shrimp19789/Chariot_strom_of_gear/firmware/chassis/TB6612LogicCheck/README.md

# TB6612LogicCheck：第2步逻辑验收

适用经典 ESP32，按 `docs/麦轮TB6612接线与面包板排线.md` 接线。编译目标 `esp32:esp32:esp32`，已在 Arduino ESP32 3.3.12 编译。本固件替换板上程序，原 PS2Catapult 源码不变。

只用于 VM 和投掷动力断开的逻辑检查。启动首先拉低 GPIO33，再拉低投掷 EN14、四轮八个 IN 和投掷相控制25/26/27；运行中持续保持低。未使用 PWM/SimpleFOC，不测试 PS2 或 AS5600，不支持任何使能、点动、制动命令。

串口115200，以换行结束：`STATUS` 输出主控引脚数字回读；`STOP` 再次拉低所有上述输出并回复。其他命令和超长行报错且保持禁用。每秒自动输出一次状态。`pads_low=1` 只表示这些主控引脚当前数字采样为低，不能证明远端接线、模拟电压或复位期间无短暂脉冲。

保持动力断开，在两块驱动板各自端子测 VCC、PWMA、PWMB 应约3.3V，STBY应约0V。冷启动/下载/复位阶段需要外部10kΩ下拉，瞬态需示波器或逻辑分析仪验证。该固件不能替代这些测量，不能作为第3–5步动力验收固件。
