shrimp19789/Chariot_strom_of_gear/docs/排错对话log.md

工具可用：6 秒内发了 7 次，板上 `duty=0,128,0,0` 反复到满、`STBY=1`，退出时自动发了 `STOP` 回到 `LOCKED`。

---

# 第 1 步结论：共因故障

| 已验证 | 结论 |
|---|---|
| 电机直连电源 → 转 | 电机、齿轮箱、轮子、电源本身 **全部正常** |
| FL（GPIO16/17）不转 | — |
| **RL（GPIO18/19）6V/50% 不转** | GPIO18/19 在任何 ESP32 模块上都安全，**排除 PSRAM 占用** |
| **两个轮子都不转** | **排除 FL 接线错位、排除单个 GPIO 问题** |

**所以故障在两者共有的环节。** 我之前列的三条 FL 特有嫌疑（PSRAM、FL 排线、FL 电机）**全部排除**。

---

# 剩下的嫌疑人（都是共有的）

按我的怀疑程度排序：

### 🔴 1. STBY 那条线实际没通到板上（最大嫌疑）

理由很硬：

- **STBY 是唯一的共用使能** —— 它一低，两块板一起待机，**四个轮子在任何 VM 下都不会动**
- 你实测 **STBY = 0.4V**，而固件同时报 `STBY=1`。**GPIO33 读回是高电平，板端子却是 0.4V —— 中间差 2.9V，这根线有问题**
- 0.4V 既不是干净的 0V、也不是 3.2V。**这是整份数据里最反常的一个数字**，验收记录自己也标注了"不能写成0V"，但从没解释过它
- 它**完美解释"6V 也不转"** —— VM 再高，芯片在待机就是不输出

**注意**：第 7 排是全表最复杂的一排 —— GPIO33、D1 STBY、10kΩ 下拉三个东西在同一个网络上，再加一条跨槽桥。**放错一位的代价恰好就是"STBY 被 10kΩ 拉死"。**

### 🔴 2. 功率地缺失

电机电流要有回路：`VM → 芯片 → BO1 → 电机 → BO2 → 芯片 → 功率GND → 电源负极`。
**如果 D1 的功率 GND 没接到公共地端子，逻辑电压全正常、电机却一点不转。** 验收单里 `G-01`/`G-02` 那两行还是空的。

### 🔴 3. VM 从未在板端子上量过

你说"现在就是6V"，但那大概是**电源显示的读数**。验收单 `M-01`/`M-02` 至今空着 —— 电源显示 6V、板端子 0V，是可能的。

### 4. IN 引脚没真带着 PWM（第 3–6 排排错）
### 5. 电源限流太小，一启动就进恒流、VM 塌陷

---

# 现在做第 2 步：边持续点动边测

工具已经就绪。**跑这条命令（30 秒），然后在这 30 秒里量 D1 的四个点：**

```powershell
python host\jog_loop.py --wheel RL --duty 128 --seconds 30
```

**万用表直流档，黑笔接已确认的公共地，红笔点器件端的针。** 直流档读的是**平均值**，所以 50% 占空比会显示约一半的值 —— 这正是判断依据。

RL 走的是 D1 的 **B 通道**，所以测这四个：

| 测点 | 在 D1 的哪根针 | 应该读到 | 读到别的说明什么 |
|---|---|---|---|
| **VM–GND** | `VM` | **≈6V 稳定** | 0V 或来回跳 → 供电/限流/**功率地没通**（嫌疑 2、3、5） |
| **STBY–GND** | `STBY` | **≈3.2V** | 仍是 **0V 或 0.4V → STBY 线没通，芯片一直待机**（嫌疑 1） |
| **BIN1–GND** | `BIN1` | **≈1.6V**（50%×3.3V） | ≈0V → IN 线或面包板第 5 排排错（嫌疑 4） |
| **BO1–BO2** | `BO1` 与 `BO2` 两针之间 | **≈3V**（50%×6V） | 前三个都对、这个为 0 → 驱动板本身坏 |

**判定逻辑是一条链，测到哪一步断掉，答案就在那里：**

```
VM 有 6V？
 ├ 没有 → 供电/地的问题，与固件无关
 └ 有 → STBY 有 3.2V？
         ├ 没有 → 【就是它】STBY 那条线 / 10kΩ 位置
         └ 有 → BIN1 有 1.6V？
                 ├ 没有 → IN 排线错（第 5 排）
                 └ 有 → BO1-BO2 有 3V？
                         ├ 没有 → 驱动板坏
                         └ 有 → 电机侧（但第 0 步已证明电机好）
```

**这四个数一出来，基本就定案了。** 其中 **STBY 那格最关键** —— 我赌它读不到 3.2V。

---

## 两个补充

**① 别只测 D1。** 顺手在 D2 的 `STBY` 上也量一下：如果 D2 也读不到 3.2V，那就确认是**共用的 STBY 链路**（第 7 排 + 跨槽桥）的问题，一处修好四个轮子都活。

**② 那个 94% 的循环对"看轮子"够用，对"测电压"略勉强。** 如果你想要一个**完全不间断**的稳态输出（点一下就一直转，靠 `STOP` 或按任意键停），我可以给固件加一条 `HOLD <轮> <占空比>` 命令并重新烧录 —— 那样测量会舒服得多，也不用和 800ms 赛跑。要的话我直接做。

---

`host/jog_loop.py` 是新加的文件，现在还没提交。要我把它一起提交吗？（它会进 `host/`，和 `serial_watch.py` 那几个诊断脚本放一起。）
---

用户：
发现问题：VM–GND是6V稳定 STBY-GND是3.3V BIN1-GND在1.6V和0V之前反复跳动 BO1-BO2显示0V

---
这组数据很干净，**而且推翻了我的首要嫌疑** —— STBY 是好的。

## 先说排除掉的

| 读数 | 结论 |
|---|---|
| **VM–GND = 6V 稳定** | ✅ 供电正常、**功率地正常**（能对公共地测出 6V 就说明地通了）、没进恒流 |
| **STBY–GND = 3.3V** | ✅ **我赌错了** —— STBY 链路是通的，芯片不在待机 |
| **BIN1 在 1.6V/0V 间跳** | ✅ **这是正常的**，见下 |

**BIN1 那个"跳动"要解释一下**：我用 `jog_loop` 是每 800ms 发一次点动、间隔约 60ms。所以占空比 50% 时 BIN1 平均是 1.6V，而那 60ms 间隙里固件归零 → 0V。**万用表跟着在 1.6V 和 0V 之间摆，恰好证明 BIN1 上有真实的 50% PWM。这不是故障，是测法造成的。**

所以输入侧全部正常：**VM 有、STBY 高、BIN1 有 PWM。**

---

## 关键矛盾：输入全对，输出为 0

**`BO1–BO2 = 0V` 是整份数据里唯一的异常，而且是决定性的。**

按真值表，把 PWM 脚视为总闸：

| PWMB | BIN1 | BIN2 | 输出 |
|---|---|---|---|
| **H** | PWM | L | **交替：驱动 6V ↔ 高阻滑行** → 万用表应读 **≈3V** |
| **L** | 任意 | 任意 | **一直短路制动，两输出都拉低** → **读 0V** ✅ 完全吻合 |
| H | L | L | 高阻 Stop → 读 0V ✅ 也吻合 |

**能产生 `BO1-BO2 = 0V` 的只有两种情形，都指向具体位置：**

### 🔴 嫌疑 A：PWMB 没真的在 3.3V（最可能）

**关键点：`PWMA`/`PWMB` 是纯硬件接死的，固件根本不碰这两个脚** —— 所以它们不是 3.3V 就只能是接线问题，而且**一错就让整条 B 通道全灭**。

你的 PWMA/PWMB=3.2V 是**很早测的**（当时 STBY 还是 0.4V，即锁定态）。之后排线动过好几轮。第 9 排的 3.3V 是从**左电源轨另取一孔**引到 a9 的 —— 那根跳线若掉了或插错到 GND 轨，现象就正好是现在这样。

### 🔴 嫌疑 B：BIN1 的跳线没通到芯片

如果 `e5 → D1 BIN1` 那根没通，芯片看到的 BIN1 就是低 → `IN1=IN2=L` + `PWM=H` → **高阻 Stop → 0V**。你在面包板侧量到 1.6V，但芯片没收到。
（这也是为什么下一步要**贴着板子针脚量**。）

### 🟠 嫌疑 C：D1 这块板已经坏了

必须提这一点：**最早几次测试是在 VM=12V 上跑一颗额定 3–6V 的电机。** 那是过压 2–4 倍，堵转电流可能远超单路 1.2A 的额定。TB6612 有过流/过温保护，触发后可能锁存。**而且从记录看，这颗板从来没成功驱动过任何电机。**

---

## 下一步：三条测量，一次定案

### 第 1 优先：量 PWMB（顺便 PWMA）

```powershell
python host\jog_loop.py --wheel RL --duty 128 --seconds 40
```

RL 跑起来后，**贴着 D1 的针脚**量：

| 测点 | 应读 | 读到别的 → 结论 |
|---|---|---|
| **D1 `PWMB`–GND** | **3.2~3.3V** | **0V 或悬空 → 嫌疑 A，就是它** |
| **D1 `BIN2`–GND** | **0V 恒定** | 也在跳 → BIN1/BIN2 短路或错位 |

### 第 2：让 FL 也跑一次（它从没被公平测过）

```powershell
python host\jog_loop.py --wheel FL --duty 128 --seconds 40
```

**这一点很重要**：FL 之前三次测试都是 **3V + 弱参数**（duty 9/12/96、400ms），从来没在 6V/128/800 下测过。所以 **FL 的"不转"可能纯粹是推力不够，而不是故障。**

量 D1 的 **`PWMA`** 和 **`AIN2`**（AIN2 应恒 0V）。如果 PWMA 正常、FL 也转了 → **说明只有 B 通道有问题，A 通道是好的。**

### 第 3：拿 D2 做对照 —— 这能一刀切开"坏板"和"接线"

```powershell
python host\jog_loop.py --wheel FR --duty 128 --seconds 40
```

FR 在 **D2 的 A 通道**（GPIO23/32），量 **D2 的 `PWMA` 和 `AO1–AO2`**：

| D2 结果 | 结论 |
|---|---|
| D2 的 AO1–AO2 有 ≈3V、轮子转 | **D1 这块板有问题**（嫌疑 C），D2 好 |
| D2 也 0V | **共因**，回到"PWMA/PWMB 的 3.3V 供法"上（第 8、9 排 + 左右轨取电） |

---

## 判定速查

```
D1 PWMB 是 3.3V 吗？
├ 不是 ────────────────► 嫌疑 A：补/换第 9 排那根 3.3V 跳线，收工
└ 是 → BIN1 贴着针脚还有 1.6V 吗？
        ├ 没有 ─────────► 嫌疑 B：e5→BIN1 跳线断了
        └ 有 → D2 的 AO1-AO2 有 3V 吗？
                ├ 有 ────► 嫌疑 C：D1 坏板，换板
                └ 没有 ──► 两块板都 0V，查 PWMA/PWMB 的 3.3V 分配（第 8/9 排 + 轨）
```

---

## 顺带两件事

1. **`host/jog_loop.py` 还没提交**，要我提吗？（它已经在排查里起了关键作用，值得留在 `host/` 里）
2. **测量时黑笔一定接已确认的公共地**，而且要**贴着模块针脚量** —— 量面包板那一侧会掩盖"跳线到模块之间断掉"这类故障，这正是嫌疑 B 的形态。

我赌 **PWMB**。把那两个数报我。
