shrimp19789/Chariot_strom_of_gear/docs/烧录测试记录.md

# Arduino 烧录测试记录

> 本记录写于仓库重组前；当时路径 `D:\dsh\1001\ESP小车项目\` 即现在的仓库根。固件在 `firmware/`、脚本在 `host/` 与 `tools/`、日志在 `docs/logs/`。

日期：2026-10-05（北京时间）

已阅读项目 `README.md`、`docs/ESP32-2804-FOC-guide.md`、`docs/诊断记录-第一阶段.md`，并检查现有固件与烧录脚本。

## 已完成

- 实测串口：COM9，USB-SERIAL CH340，VID:PID=1A86:7523。COM7/COM8 是蓝牙串口。
- 实测芯片：ESP32-D0WD-V3，revision v3.1；Flash 4 MB；MAC 08:a6:f7:a8:95:94。
- 编译目标：esp32:esp32:esp32；ESP32 core 3.3.12；Simple FOC 2.4.0。
- Stage1_AS5600Test 编译通过：程序 320316 字节（24%）；全局变量 23564 字节（7%）。
- 以 115200 上传成功，bootloader、分区表、boot_app0、应用均通过写入哈希校验，退出码 0。
- 上传后复位并读取串口 10 秒，新固件正常启动；GPIO14 EN 拉低。
- AS5600 在 GPIO21 SDA / GPIO22 SCL 的 I2C 地址 0x36 应答。
- 采样读数稳定：raw=598，deg=52.56，MD=1，ML=1，MH=0，changes=1。
- Stage2_FOCClosedLoop 编译通过：程序 328852 字节（25%）；全局变量 24500 字节（7%）。仅编译，未上传，未解除配置锁。
- 用户回复“开始”后采集 30 秒动态测试数据：60 条 I2C ERROR，0 条有效角度样本；无法验证角度范围与回绕。
- 动态测试后复位并发送 S 重扫：GPIO21 空闲=0，GPIO22 空闲=1；0x36 无应答；总线扫描发现 0 个器件，NACK=112，超时=0。

## 结论与限制

串口、两个阶段的编译、第一阶段上传和启动均通过。编码器初次读取正常，但动态采集时通信失败，复位后依旧无应答；编码器测试未通过。

初次 ML=1 表示传感器报告磁场偏弱。动态采集没有有效角度，无法判断整圈范围、回绕或运动时磁场状态。现象提示接线或供电不稳定，但不能仅凭这些读数证明线断或芯片损坏。优先断电检查 GPIO21 到编码器 SDA 的通断及接触，再检查 VCC 和 GND；通信恢复后核对磁铁距离与对中。

尚未执行电机校准或带电试转，第二阶段配置保持 CONFIG_CONFIRMED=false。板上保留第一阶段诊断固件，串口读取结束后已关闭。

## 工具问题

原 MCP 串口读取函数收到数据后会把截止时间延长 0.4 秒，持续输出会导致读取不返回并占用串口。USB 重插后占用释放，本次后续验证使用固定截止时间的独立脚本，读取结束后关闭串口。未修改原项目和 MCP 服务源码。

原始日志（均在 `docs/logs/` 下）：stage1-startup.txt、stage1-rotation.txt、stage1-recheck.txt。
