shrimp19789/Chariot_strom_of_gear/docs/环境检查报告.md

# 本机环境检查报告

> 本记录写于仓库重组前；当时路径 `仓库根` 是行驶底盘子项目，现已并入本仓库：固件在 `firmware/chassis/`、脚本在 `host/` 与 `tools/`。下文旧路径已更新。

检查时间：本次会话
检查目标：Arduino / Codex 能否调用，串口与 ESP32 板子现状，以及为完成「链路检测 + 电机驱动」
还缺什么。

---

## 一、总体结论

| 检查项 | 结论 | 证据 |
|---|---|---|
| Arduino IDE | ✅ 有（**便携版**，不在 PATH） | `D:\Download\arduino\Arduino IDE.exe`，版本 2.3.10 |
| arduino-cli | ✅ 有且可调用 | 1.5.1，藏于 IDE 内部 |
| ESP32 核心 | ✅ 已装齐 | `esp32:esp32 3.3.12` |
| AVR 核心 | ✅ 已装 | `arduino:avr 1.8.8` |
| ESP8266 核心 | ✅ 已装 | `esp8266:esp8266 3.1.2` |
| Codex | ✅ 有且可调用 | `codex-cli 0.160.0` |
| 电机驱动板 | ✅ 型号已确认 | 奇果派 QGPMaker（PCA9685） |
| 串口板子 | ⚠️ **未插入** | COM9 = CH340，状态 `Unknown` |
| 网络 | ✅ 可用 | 7gp.cn 返回 200；pip 可下载 |

**两个工具都能调用，板子确实还没插上——与你的说明一致。**

---

## 二、Arduino 工具链

### 2.1 关键路径

| 用途 | 路径 |
|---|---|
| IDE 启动器 | `D:\Download\arduino\Start Arduino IDE.cmd` |
| arduino-cli | `D:\Download\arduino\resources\app\lib\backend\resources\arduino-cli.exe` |
| arduino-cli 配置 | `D:\Download\arduino\data\arduino-cli.yaml` |
| 数据目录（核心/工具链） | `D:\Download\arduino\data` |
| 项目目录（sketchbook） | `D:\Download\arduino\sketchbook` |

**为什么 `arduino-cli` 不在 PATH**：这套 Arduino 是**便携（portable）安装**——
数据目录被搬到了 D 盘（`Start Arduino IDE.cmd` 里写明原因是 C 盘只剩约 9GB）。
因此必须显式指定 `--config-file`，否则 arduino-cli 会去默认位置找核心、然后找不到 ESP32。

### 2.2 已安装核心与工具链

```
arduino:avr      1.8.8
esp32:esp32      3.3.12     ← 完整
esp8266:esp8266  3.1.2
```

ESP32 工具链齐全：

```
esp-x32 / esp-rv32              (编译器)
esptool_py 5.3.1                (烧录)
openocd-esp32 v0.12.0-esp32-20260424
esp32-libs / esp32c3/…/esp32s3-libs  3.3.12
xtensa-esp-elf-gdb / riscv32-esp-elf-gdb  17.1_20260402
mklittlefs 4.0.2
```

### 2.3 一个必须记住的坑

`Start Arduino IDE.cmd` 里有一条注释值得抄下来：

> `--disable-gpu-sandbox` 在本机是**必需**的。没有它，Electron 的 GPU 进程会以
> `0xC0000135`(STATUS_DLL_NOT_FOUND) 崩溃，IDE 会立刻退出。

**所以请始终用 `Start Arduino IDE.cmd` 启动 IDE，不要直接双击 `Arduino IDE.exe`。**

### 2.4 已安装的驱动库

| 库 | 状态 |
|---|---|
| `QGPMakerMotorShield_Lib_V5.2` | 原有（厂家库，AVR 版） |
| `QGPMakerMotorShield_ESP32` | **本次新增**，见第五节 |

---

## 三、Codex

### 3.1 结论

| 项目 | 值 |
|---|---|
| 版本 | `codex-cli 0.160.0` |
| 主程序 | `C:\Users\jiahe\AppData\Local\OpenAI\Codex\bin\f544b3844e0f14e9\codex.exe` |
| 是否在 PATH | ❌ 不在（需用全路径调用） |
| 配置 | `C:\Users\jiahe\.codex\config.toml` |
| 日志库 | `C:\Users\jiahe\.codex\logs_2.sqlite`（1859 条） |
| 状态库 | `C:\Users\jiahe\.codex\state_5.sqlite` |

同目录还有 `codex-code-mode-host.exe`、`codex-command-runner.exe`、
`codex-windows-sandbox-setup.exe`。

### 3.2 挖日志的结果：**Codex 日志里没有 ESP32 相关内容**

在 `logs_2.sqlite` 里逐关键字 LIKE 查询，**全部 0 命中**：

```
esp32 / arduino / motor / COM9 / CH340 / CP210 / serial /
pyserial / platformio / 电机 / 串口 / 驱动 / 舵机 / servo / stepper / L298 / TB6612 / pwm
```

原因也很清楚：

- 日志时间窗只有 **2026-10-05 17:09:09 → 18:23:04**（约 74 分钟）
- `state_5.sqlite` 的 `threads` 表**为空**（0 行）
- 磁盘上**没有** rollout `/ sessions/` 会话文件

也就是说这台 Codex 是**刚装不久、还没积累对话**，所以没有 ESP32 上下文可挖。
（`logs_2.sqlite` 里绝大部分是登录 `codex_login::auth::manager`、
WebSocket 传输和模型缓存类的记录。）

### 3.3 但挖到了关键线索：ChatGPT 项目镜像

真正有用的是这个文件：

```
C:\Users\jiahe\.codex\.chatgpt-projects\g-p-6ac37786ec188191b2b79cf5d7cf8330\AGENTS.md
```

内容：

```markdown
# ChatGPT project context
This directory is a local mirror of the ChatGPT project "ESP32".
- Treat every file under `sources/` as read-only reference material.
- ...
```

→ **存在一个名为 “ESP32” 的 ChatGPT 项目**，这印证了你的目标平台就是 ESP32。
（注意：该镜像的 `sources/` 目录目前是**空的**，项目文件还没同步下来。）

---

## 四、串口与板子现状

### 4.1 端口枚举

| 端口 | 设备 | 状态 | 判断 |
|---|---|---|---|
| COM7 | 蓝牙链接上的标准串行 | OK | 蓝牙虚拟串口，**忽略** |
| COM8 | 蓝牙链接上的标准串行 | OK | 蓝牙虚拟串口，**忽略** |
| **COM9** | **USB-SERIAL CH340** | **Unknown** | **就是你的板子，当前未插入** |

### 4.2 COM9 的进一步证据

- 注册表仍保留设备记录：
  `HKLM\SYSTEM\CurrentControlSet\Enum\USB\VID_1A86&PID_7523\5&347eed33&0&5`
- `VID_1A86 : PID_7523` = **CH340** USB 转串口芯片，
  ESP32 开发板（以及 UNO 兼容板）上最常见的那颗。
- 状态 `Unknown` = **设备当前不在场**（之前插过、驱动装过、现在拔了）。

**结论：CH340 驱动已经装好了**（`D:\Download\arduino\drivers\CH341SER.EXE` 也备着，
备用 CP210x 驱动在 `drivers\CP210x\`）。插上板子后应当能直接识别，
若真的没驱动再运行 `drivers\latest\Install-Latest-Drivers.cmd`。

### 4.3 怎么确认板子插上了

```powershell
tools\build-chassis.ps1 -ListBoards
# 或者
python host\motor_link_check.py --list
```

---

## 五、本次对本机做的改动（透明清单）

只做了**新增**，没有修改或删除任何原有文件。

### 5.1 安装了 Python 库

```
python -m pip install pyserial        →  pyserial 3.5
```
（上位机检测脚本需要它读串口。）

### 5.2 新增了一个 ESP32 版的驱动库

**问题**：厂家那份 `QGPMakerMotorShield_Lib_V5.2` **无法在 ESP32 上编译**：

```
PinChangeInterrupt.h:30:10: fatal error: avr/io.h: No such file or directory
```

因为该库目录里捆了 AVR 专用的 `PinChangeInterrupt*.cpp`（编码器功能用），
而 arduino-cli 会把库目录下所有 `.cpp` 都拿去编译 → ESP32 必然失败。

**这也是为什么厂家在资料包里**（`_net_test\7gp\v56\`）**单独放了一个 `esp32` 目录**。
对比后确认：

| 文件 | V5.2 版 vs 厂商 ESP32 版 |
|---|---|
| `QGPMaker_MotorShield.cpp` / `.h` | **完全相同**（SHA-256 一致） |
| `Adafruit_MS_PWMServoDriver.h` | **完全相同** |
| `Adafruit_MS_PWMServoDriver.cpp` | 内容相同，**仅换行符不同**（CRLF vs LF） |
| `PinChangeInterrupt*.cpp/.h` | 厂商 ESP32 版**故意不提供** |

**解决办法**：新增一个带 `library.properties`、且 `architectures=esp32` 的库：

```
D:\Download\arduino\sketchbook\libraries\QGPMakerMotorShield_ESP32\
├── library.properties          (architectures=esp32)
└── src\
    ├── QGPMaker_MotorShield.h        ← 取自厂商 ESP32 版
    ├── QGPMaker_MotorShield.cpp
    ├── Adafruit_MS_PWMServoDriver.h
    └── Adafruit_MS_PWMServoDriver.cpp
```

**为什么这样最干净**：arduino-cli 会按目标架构选库。
实测已验证两条路都正常：

```
Alternatives for QGPMaker_MotorShield.h:
  [QGPMakerMotorShield_Lib_V5.2  QGPMakerMotorShield ESP32@5.6.0]
  → 给 ESP32 编译时选中 QGPMakerMotorShield ESP32@5.6.0   ✔
  → 给 UNO 编译时仍用原 V5.2 库（DCMotorTest 编译通过）   ✔
```

也就是说：**你原来的 UNO 工作流完全不受影响**，ESP32 也能编了。

### 5.3 新增项目文件

全部在 `仓库根` 下，详见 `docs/底盘链路检测与驱动.md`。

---

## 六、验证结果

### 6.1 编译矩阵（全部通过）

| 固件 | ESP32 Dev | ESP32-S3 | ESP32-C3 | UNO | Mega |
|---|---|---|---|---|---|
| MotorLinkCheck | ✅ 317,092 B | ✅ 323,409 B | ✅ 328,580 B | ✅ 12,844 B | ✅ 13,710 B |
| MotorDriver | ✅ 317,824 B | ✅ 323,929 B | ✅ 329,694 B | ✅ 14,108 B | ✅ 14,942 B |

（固件特意写成**跨平台**的：ESP32 用 `Serial.printf`，AVR 没有，所以统一走了一个
自写的 `pf()` 函数；AVR 的 I2C 引脚固定在 A4/A5，也做了分支处理。）

### 6.2 上位机脚本（已在**无板子**条件下验证容错）

```
$ python motor_link_check.py --list
本机共有 2 个串口:
  COM8  蓝牙链接上的标准串行 (COM8)   是蓝牙虚拟串口, 不是开发板  (蓝牙, 忽略)
  COM7  蓝牙链接上的标准串行 (COM7)   是蓝牙虚拟串口, 不是开发板  (蓝牙, 忽略)

$ python motor_link_check.py
!! 没有找到看起来像开发板的串口。
   （正确列出串口并提示用 --port 手动指定）
   exit = 2
```

**没有板子时它不会崩、也不会瞎报成功**，而是明确说“没有开发板串口”并以退出码 2 结束。

### 6.3 尚未验证的部分

- ❌ **实机烧录**（板子没插，无法 upload）
- ❌ **I2C 实机通信**（同上）
- ❌ **电机实际转动**
- ❌ **电流采样自动判定**（需要额外 ACS712 硬件）

以上留待板子插上后按 `README.md`「快速开始」三步执行。

---

## 七、复现本次检查的命令

```powershell
# Arduino 核心 / 库
& "D:\Download\arduino\resources\app\lib\backend\resources\arduino-cli.exe" `
    core list --config-file "D:\Download\arduino\data\arduino-cli.yaml"
& "..." lib list  --config-file "..."
& "..." board list --config-file "..."

# 串口
python -c "import serial.tools.list_ports as lp; print([(p.device,p.description) for p in lp.comports()])"

# Codex 日志（先复制 db+wal 到临时目录再查，避免锁库）
python -c "import sqlite3;c=sqlite3.connect('logs_2.sqlite');print(c.execute('select count(*) from logs').fetchone())"

# 编译验证
tools\build-chassis.ps1 -Sketch All
```
