shrimp19789/Chariot_strom_of_gear/docs/线路检查记录.md

# 线路检查记录

> 本记录写于仓库重组前；当时路径 `D:\dsh\1001\ESP小车项目\` 即现在的仓库根。固件在 `firmware/`、脚本在 `host/` 与 `tools/`、日志在 `docs/logs/`、照片在 `docs/assets/`。

日期：2026-10-05。

已查看 chariot 仓库的 README、指南、诊断记录、现有固件及模块照片。用户所称 log 对应目录中未见单独 log 文件，最相关的是《诊断记录-第一阶段.md》。

## 本次实测

COM9 可打开，固件复位启动正常。GPIO14 EN 被程序拉低。

GPIO21 SDA 空闲=0，GPIO22 SCL 空闲=1；0x36 无应答；I2C 扫描发现 0 个器件，NACK=112、超时=0。发送 L 后，50 kHz 和 10 kHz 均未发现器件。仅降低速率及启用固件中的内部上拉操作未恢复通信。

与旧诊断记录现象相似，但不能认定根因相同。旧记录曾修改对自由电平、上拉和供电的判断。无器件应答不能证明 SDA 导通；低电平不能单独证明没有上拉。未执行 G 命令：该命令会把多个未知接线的 GPIO 设为输出并拉低，不能作为任意外设的无干扰自动接线识别。

## 各模块状态

| 模块 | 已知事实 | 当前结论 | 需要验证 |
|---|---|---|---|
| 编码器 | 之前短时应答并输出 MD=1、ML=1；本次无应答 | 通信未通过，尚不能确认损坏或断线 | SDA/SCL/VCC/GND 的两端通断；模块端 VCC 和两根信号线实际电压 |
| 电机 | 项目资料为 2804 三相电机；照片可见三相插头 | 电气与运行状态未验证 | 电机与驱动分离、断电后测三组线间电阻并比较；相线到外壳绝缘；检查插头接触 |
| 降压模块 | 照片可辨认 6V~24V-IN、5V-OUT、3V3-OUT、VADJ-OUT 和 GND | 输出与共地未验证；USB 下 ESP32 启动不能证明它正常 | 模块输入电压、实际使用输出对 GND 电压；负载连接下是否稳定；实际供电落点 |
| 驱动板 | 照片接口为 IN1/IN2/IN3/EN/GND/FLT，U/V/W、电源正负 | 未验证实际 GPIO 落点、功率供电或功率输出 | 按固件核对 25/26/27/14；共地和电源极性；驱动输入端电压 |
| 蓝牙接收器 | 未提供型号与接线，项目照片中未识别到该模块；现有固件未实现其测试 | 无法确认 | 模块型号、供电、接口类型、实际 GPIO；按型号安排接收与回传测试 |

照片只能确认照片拍摄时的局部接口与插头，无法识别完整当前线路。厂家示意图标 ESP32-S3，当前板实测为经典 ESP32，不能照示意图的排针位置接线。

## 优先验证编码器

断开 USB 和电池，再用通断档测量：ESP32 GPIO21 到模块 SDA、GPIO22 到 SCL、GND 到模块 GND、实际供电输出到模块 VCC。逐条记录导通结果，不凭线色判断。项目编码器照片可读到接口顺序 VCC/GND/SCL/SDA；须以实物丝印和观察方向核对。

通断测试后，仅恢复确认过的逻辑供电，驱动功率保持断开。记录编码器模块 VCC-GND、ESP32 端 GPIO21-GND、GPIO22-GND 的电压；若 SDA 异常，再比较模块 SDA 端电压。软件不能代替这些电压和通断测量。

原始串口日志（均在 `docs/logs/` 下）：connection-current.txt、connection-low-speed.txt。串口已关闭；未覆盖固件或启动电机。
