shrimp19789/Chariot_strom_of_gear/docs/阻塞问题与烧录实测.md

# 阻塞问题与烧录实测

> 本记录写于仓库重组前。固件在 `firmware/`、脚本在 `host/` 与 `tools/`、日志在 `docs/logs/`。下文日志文件名均已位于 `docs/logs/`。

日期：2026-10-05。

## 已实际完成

- 用户要求的PS2程序已上传COM9，保留默认电机锁定；运行正常。
- 增加d命令，限于电机禁用时检查已知I2C引脚、恢复总线、低速复读；最终固件已再次编译与上传，哈希校验通过。
- 当前PS2帧稳定，模式0x41；采集期间buttons均0000，不能证明真实手柄按键响应或无线失联处理正常。
- 编码器初次新固件启动仍无应答，随后30秒采集出现间歇成功，最后诊断连续读成功。
- d诊断：GPIO21/22自由、内部下拉、内部上拉后均为高；恢复时钟脉冲0；100/50/10kHz均ACK，角度约219.20度。
- 编码器在执行恢复前已成功读取，不能声称软件总线恢复解决了原故障。
- AS5600状态0xB3，按相关位解码MD=1、ML=1、MH=0：检测到磁铁但磁场偏弱，magnetOK=0。
- 随后30秒复查再次全部读失败。再次d：自由SDA/SCL均高，内部下拉后SDA=0/SCL=1，内部上拉后均高；100/50/10kHz均addr36_error=2（地址NACK）。恢复脉冲0、STOP及重新初始化后仍无应答。
- 前后对比：应答时SDA能抵抗内部下拉，失败时不能；与SDA连接/上拉路径间歇变化相符，但需通断与电压测量确认，不能单凭此判定唯一根因。

## 当前阻止电机使能的事项

| 项目 | 事实与严重性 | 解决路径 |
|---|---|---|
| 编码器通信曾间歇失败 | 控制失去可靠角度反馈；最新短测成功不能证明问题根除 | 固定接线/供电，手转整圈及静置连续验证无错误 |
| 编码器磁场偏弱 | 已实测ML=1；程序明确拒绝使能 | 断电检查磁铁是否随轴转动、对中与间距，调整到MD=1/ML=0/MH=0 |
| 驱动功率供电不明 | 实测值未提供；代码SUPPLY_VOLTAGE=0、CONFIG_CONFIRMED=false故意锁定 | 核对驱动功率端电压及极性、ESP32供电脚落点；若驱动功率来自5V输出，不符合项目标注8.2~24V |
| FOC未完成校准、机械原点未记录 | 功率与反馈验证前不能校准 | 卸杆校准c，再按说明人工原点h；所有前提满足后a |
| 实际90度限位、急停、负载能力未验证 | 软件参考轨迹不能保证物理不越界；断驱动后可能自由下落 | 核对独立机械限位/缓冲/断电急停，先空载后验证负载 |

PS2按键与无线失联行为属于待验收项，尚未观测到其故障。GPIO2/12启动配置冲突是潜在风险，本次启动与上传均成功，不把它列为已经发生的FATAL故障。

供电、接线与磁铁位置没有远程执行器，无法用代码改变。不得把这些项目写成“已解决”。串口已关闭，电机未启动。

原始日志（均在 `docs/logs/` 下）：ps2-first-boot.txt、ps2-button-check.txt、ps2-encoder-diagnosis.txt、ps2-stability-check.txt、ps2-encoder-recheck.txt。
