shrimp19789/Chariot_strom_of_gear/docs/assets/cc612679d195754dd7da25badf9ae344.jpg

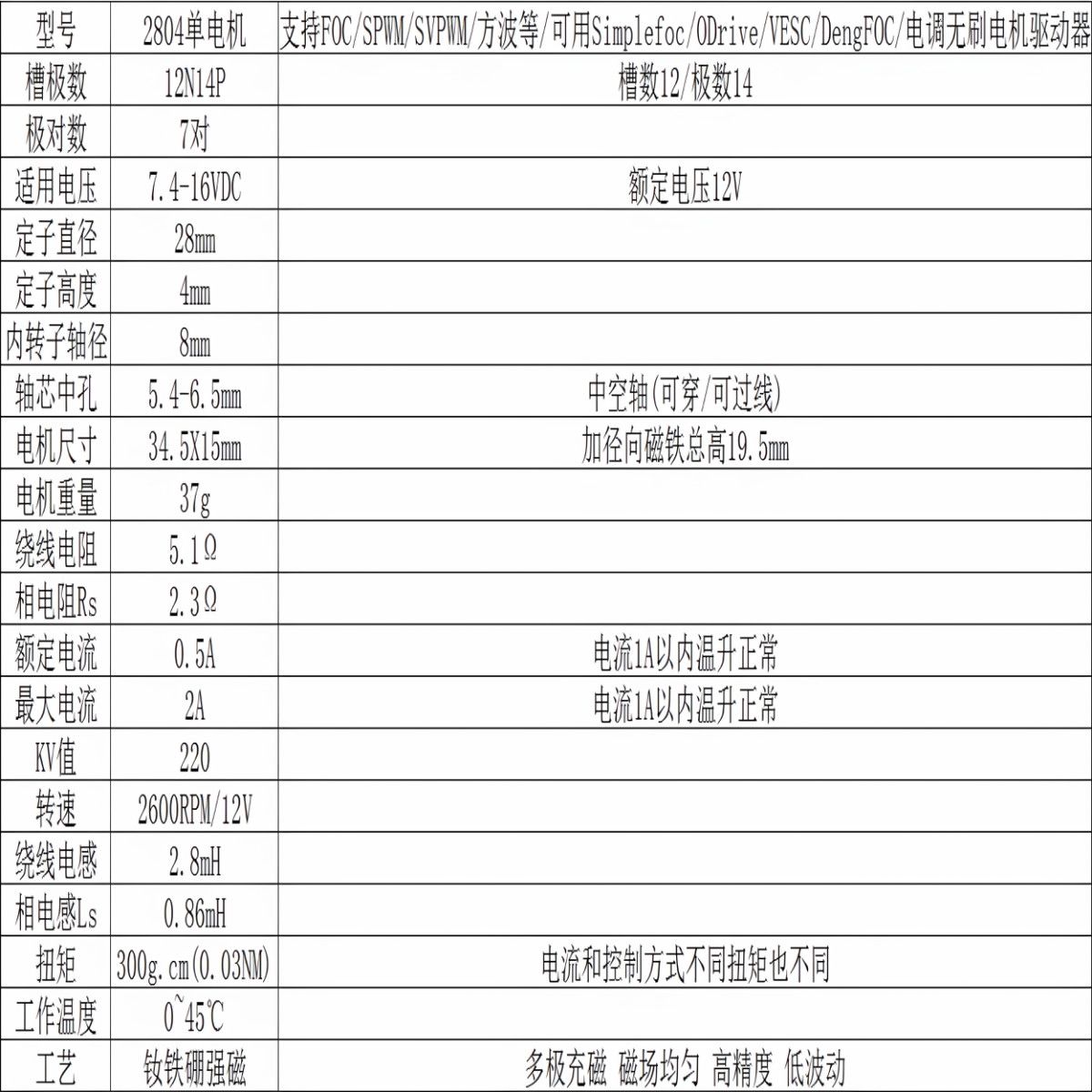
docs/assets/cc612679d195754dd7da25badf9ae344.jpg
