shrimp19789/Chariot_strom_of_gear/docs/assets/cf740fe5e1c7d5f88c907b9585950989.jpg

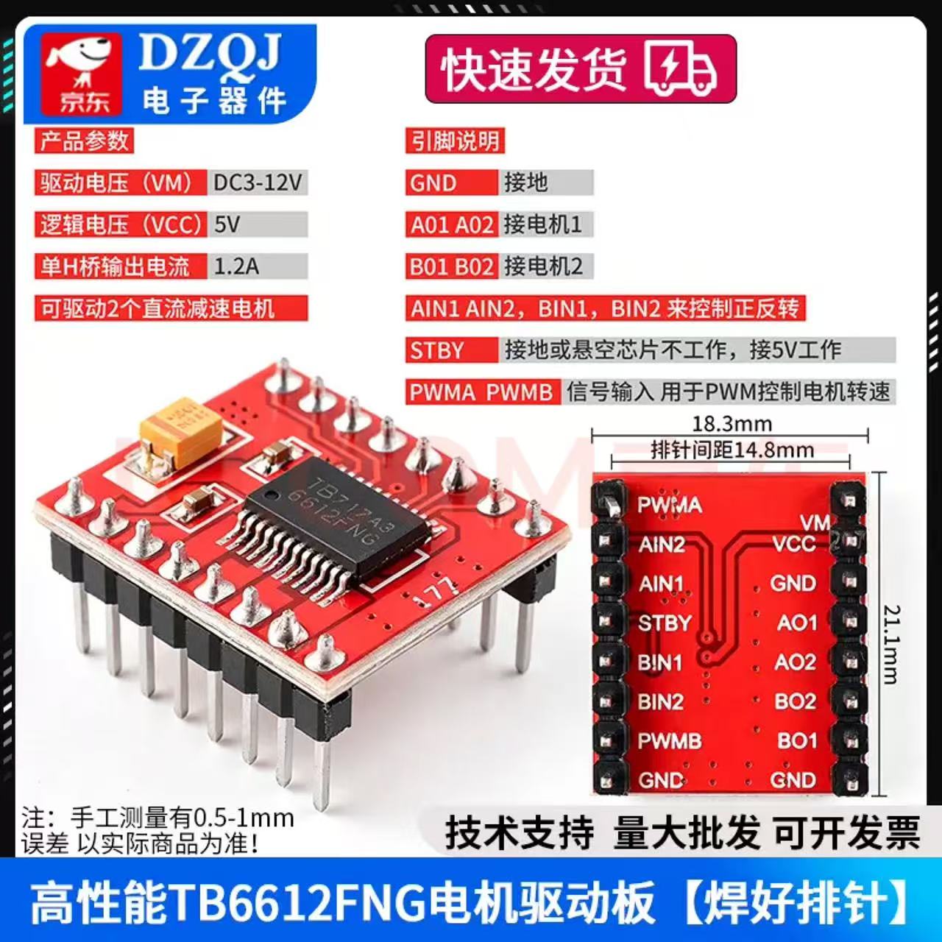
docs/assets/cf740fe5e1c7d5f88c907b9585950989.jpg
