shrimp19789/Chariot_strom_of_gear/docs/assets/d4184f2874bcdc8fea3b3960f6a12dfb.jpg

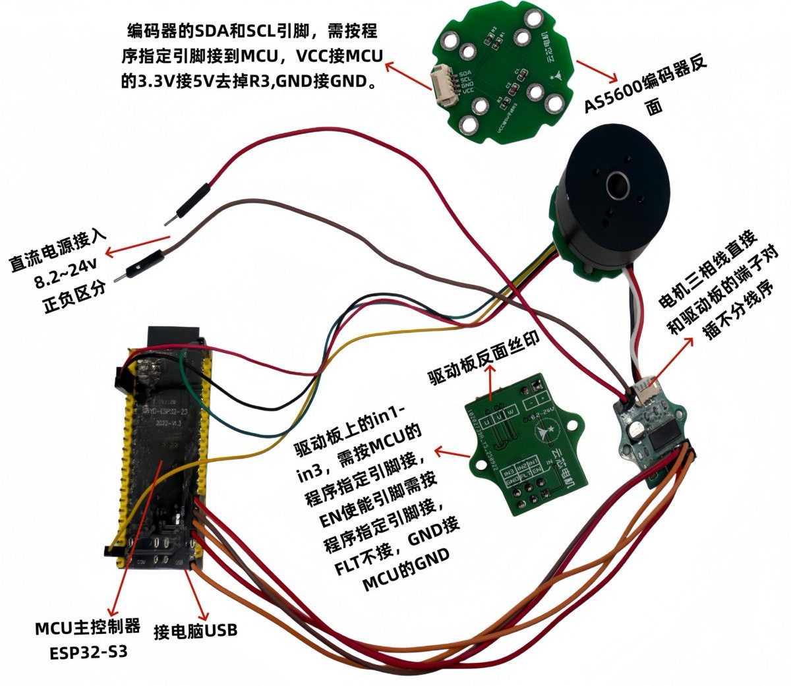
docs/assets/d4184f2874bcdc8fea3b3960f6a12dfb.jpg
