shrimp19789/Chariot_strom_of_gear/(commit log)

2026-10-06 baseline: 合并三仓库后的原始状态（重组前快照）
2026-10-06 重组：按用途分为 firmware/host/tools/docs/build，三份 README 整合为一份
    - 三仓库合一后的顶层整理：firmware（catapult 投掷 / chassis 底盘）、host（上位机）、
    tools（构建脚本 + MCP 桥）、docs（文档/日志/照片）、build（构建产物，已忽略）
    - 合并 投掷机构/底盘/MCP桥 三份 README 为单一根 README.md，原文件降为 docs/ 下的详细参考
    - 修复因 D:\\dsh\\1001 迁移而失效的 23 处硬编码路径；脚本改为基于 __file__ / \ 解析
    - 更新 ~/.codex/config.toml 的 MCP 注册路径
    - 5 份实测记录加路径说明横幅，旧路径按新布局更新
    [MotorDriver.ino, MotorLinkCheck.ino, PS2Catapult.ino, Stage1_AS5600Test.ino, Stage2_FOCClosedLoop.ino, i2c_pin_sweep.py, mcp_server.py, motor_link_check.py]
2026-10-06 接线更新
    [面包板.xlsx]
2026-10-06 对齐底盘两线法方案，并更正 18/23 过时建议
    底盘方案（采纳 Codex《麦轮TB6612接线与面包板排线》新版，该版已整份改为两线法）：
    - README：新增「2 × TB6612FNG 两线法」引脚表（16/17、18/19、23/32、15/5，STBY=33+10kΩ 下拉，
    VCC=3.3V，共 9 根输出）；奇果派 PCA9685 降为备选，并标注其代价（依赖当前有故障的 I2C）
    - README：目录地图标注 firmware/chassis 是奇果派固件、烧到 TB6612 无反应；文档索引加入两份麦轮文档
    - README：验证状态拆为「TB6612（仅方案，无固件）」与「奇果派（备选）」两行
    - README：故障排查新增 4 条 TB6612 专属现象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
    [面包板.xlsx]
2026-10-06 底盘麦轮固件与分步验收记录入档
    固件：
    - firmware/chassis/MecanumPS2/：双 TB6612 两线法四麦轮 + PS2 遥控。八路 LEDC
    （20kHz/8bit，通道 0-7）、共用 STBY=33、软启动每 10ms 变化 3 档、换向先归零
    再等 300ms、1 秒任务看门狗。含 DriveMath.h（麦轮混控 + 斜坡）与 README
    - firmware/chassis/TB6612LogicCheck/：第 2 步专用逻辑检查固件（不提供使能/运动）
    - tests/test_mecanum_drive_math.cpp：主机侧混控、幅值、零输入、换向等待、
    STOP 方向历史与计时回绕测试
    文档：
    - docs/麦轮TB6612分步验收记录-2026-10-06.md：分步验收状态、实测回填与待补证据
    - docs/全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
    [面包板.xlsx]
2026-10-06 新增 host/jog_loop.py：连续点动工具，供 TB6612 麦轮排查用
    背景：MecanumPS2 单次 JOG 上限 800ms，手持万用表来不及读数，也看不清轮子。
    - 以约 60ms 间隔重发同一条 JOG，使输出占比约 93%，可边测电平边看轮子
    - 输出实时流式打印（STATUS 仅在变化时打印，避免刷屏），每 10s 报一次进度
    - 退出前（含 Ctrl+C）必发 STOP，确保回到 LOCKED
    - 只重发固件本就接受的 JOG，不放大占空比、不改时长上限
    - 启动时打印测量点提示与堵转发热警告
    - 内部按行缓冲，避免串口读块跨行导致 STATUS 被截断
    README：文件地图的 host/ 段落补入该脚本，并注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
2026-10-07 排错：小车麦轮无法转动
